MixedRealityLab/UbiDesign/protocol/component_images/shower hose.jpg

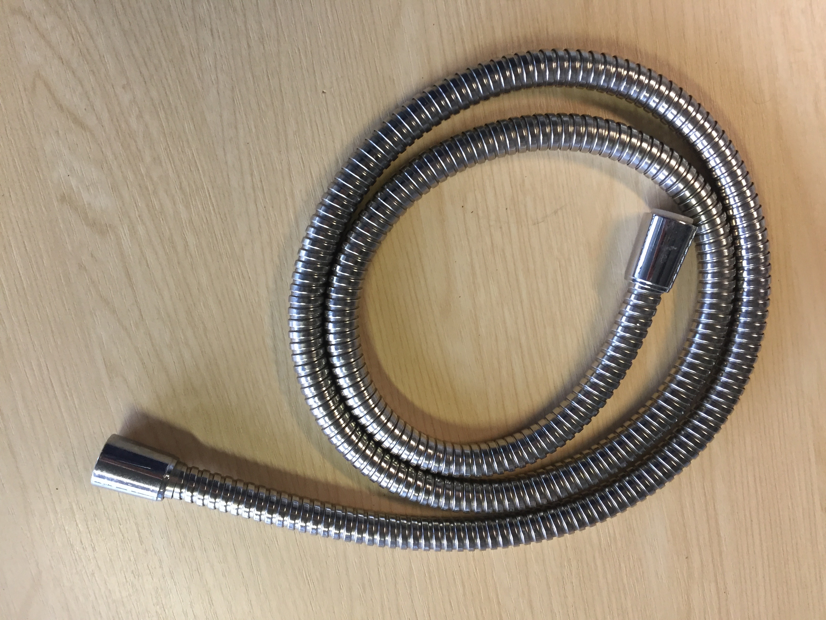
protocol/component_images/shower hose.jpg
