MixedRealityLab/UbiDesign/protocol/component_images/jst pcb header.jpg

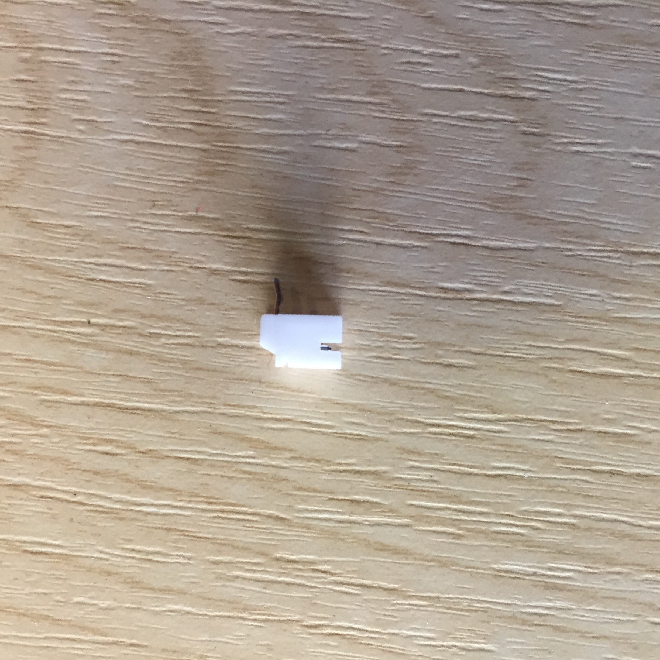
protocol/component_images/jst pcb header.jpg
