MixedRealityLab/UbiDesign/protocol/component_images/electronics for shower monitor.jpg

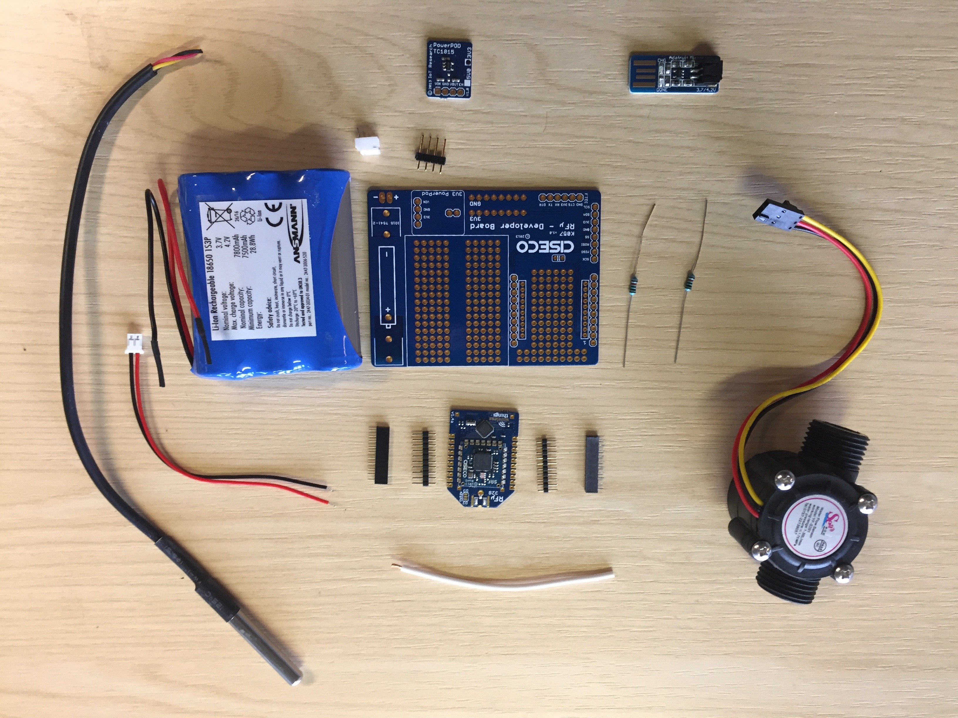
protocol/component_images/electronics for shower monitor.jpg
