MixedRealityLab/UbiDesign/protocol/component_images/2mm header pins.jpg

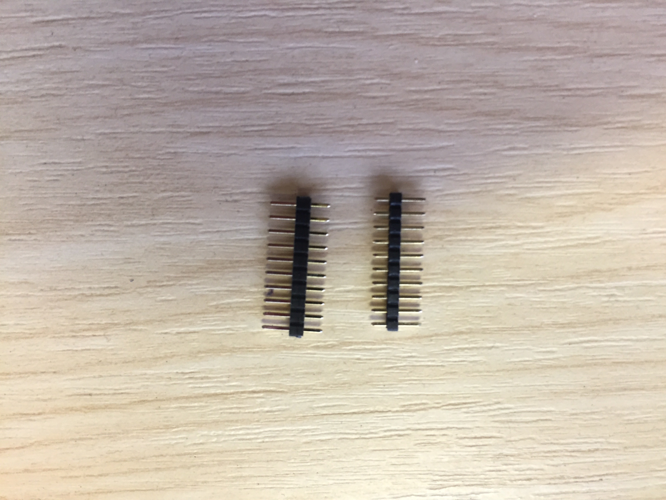
protocol/component_images/2mm header pins.jpg
