MixedRealityLab/UbiDesign/protocol/component_images/2mm sockets.jpg

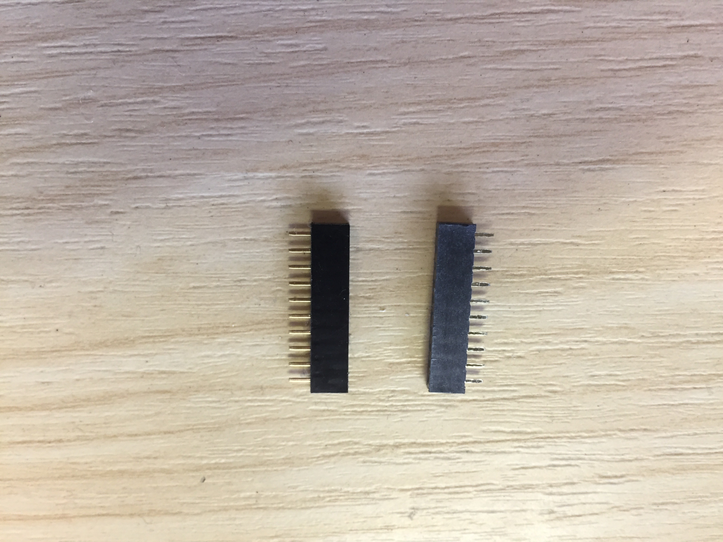
protocol/component_images/2mm sockets.jpg
