MixedRealityLab/UbiDesign/protocol/component_images/4 core white sheathed wire.jpg

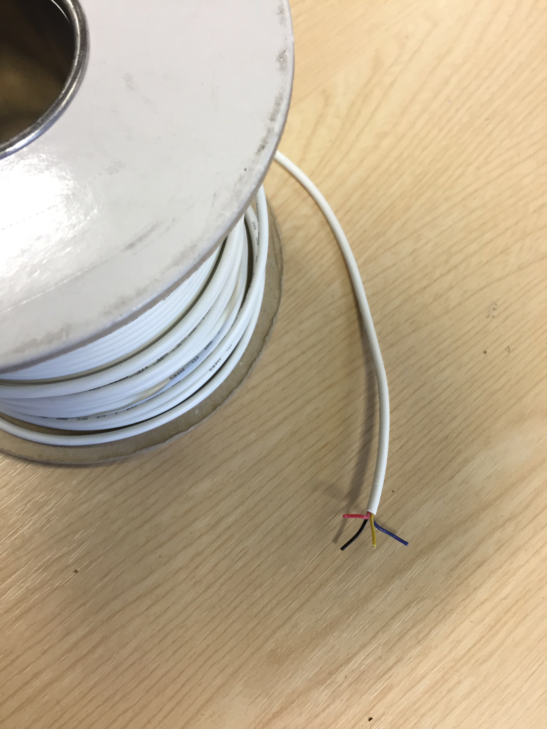
protocol/component_images/4 core white sheathed wire.jpg
