MixedRealityLab/UbiDesign/protocol/component_images/10k resistors.jpg

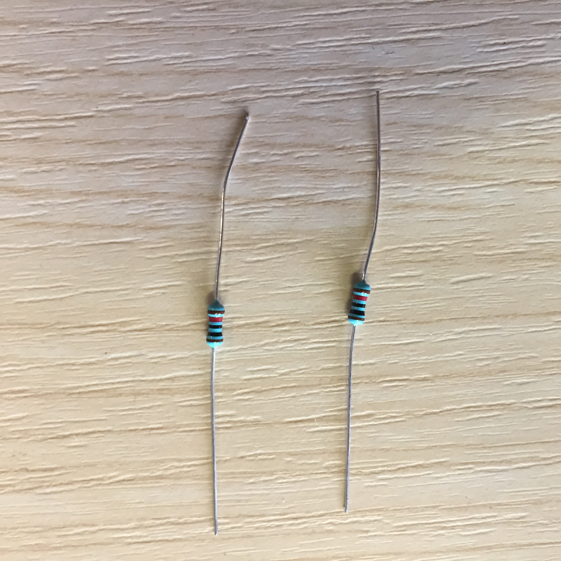
protocol/component_images/10k resistors.jpg
