MixedRealityLab/UbiDesign/protocol/component_images/15mm push fit to BSP hose.jpg

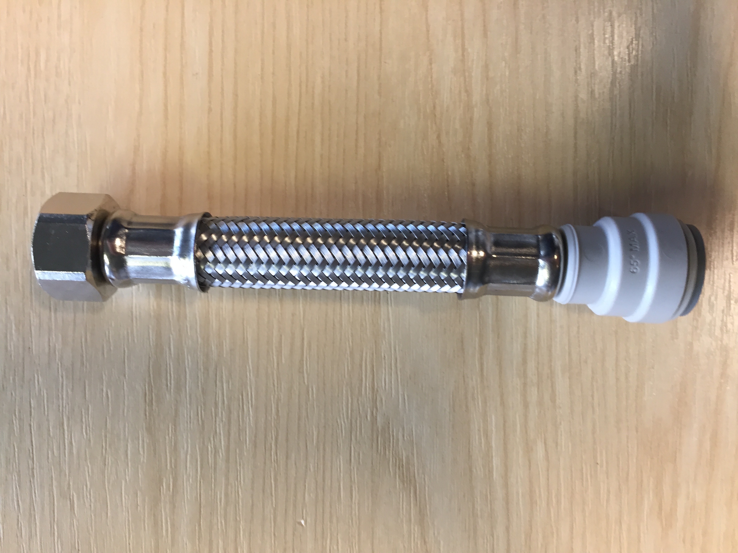
protocol/component_images/15mm push fit to BSP hose.jpg
