MixedRealityLab/UbiDesign/protocol/component_images/15mm push fit to bsp plastic.jpg

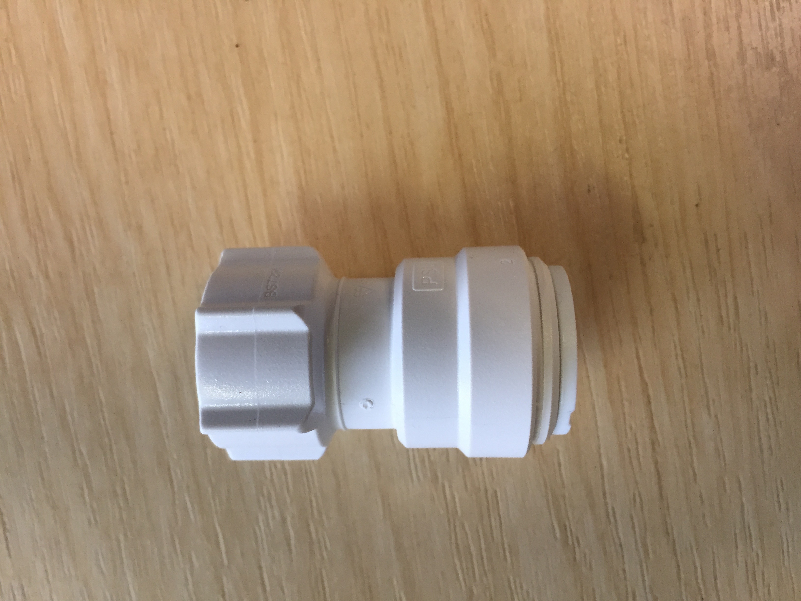
protocol/component_images/15mm push fit to bsp plastic.jpg
