MixedRealityLab/UbiDesign/protocol/component_images/22awg single core wire.jpg

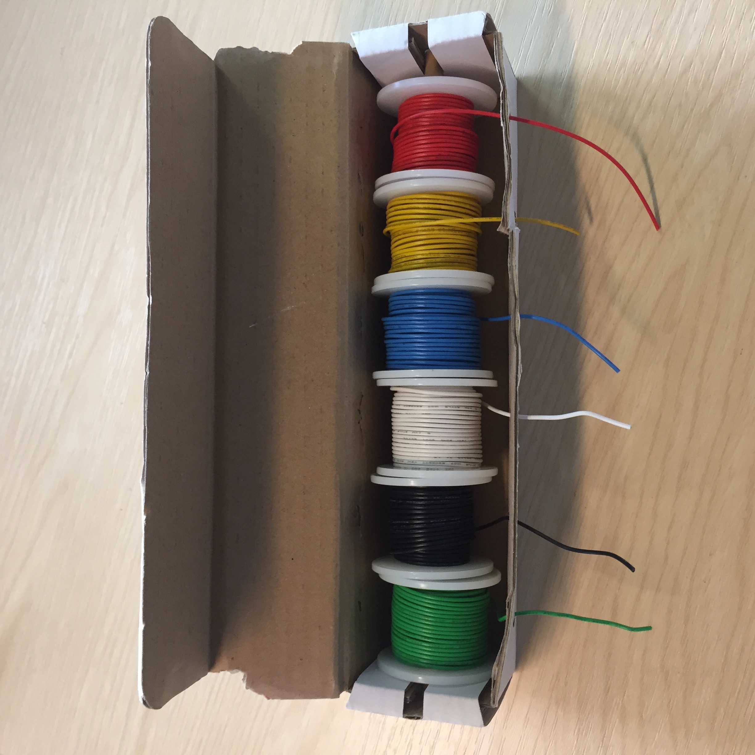
protocol/component_images/22awg single core wire.jpg
