MixedRealityLab/UbiDesign/protocol/component_images/500g load cell 1.jpg

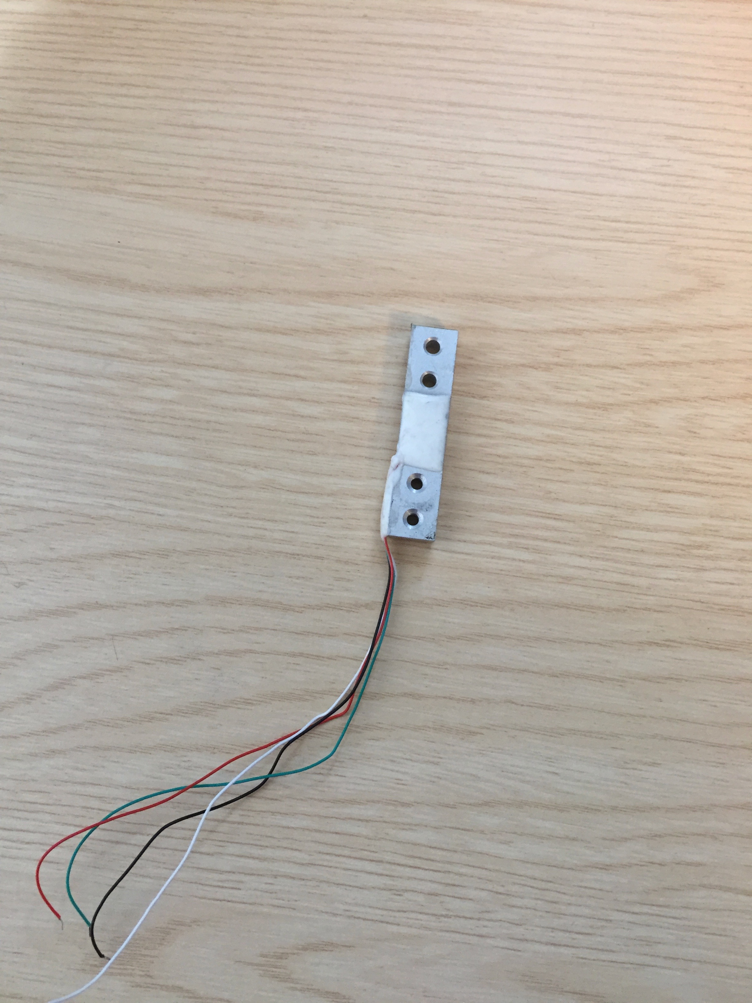
protocol/component_images/500g load cell 1.jpg
