MixedRealityLab/UbiDesign/protocol/component_images/500g load cell 2.jpg

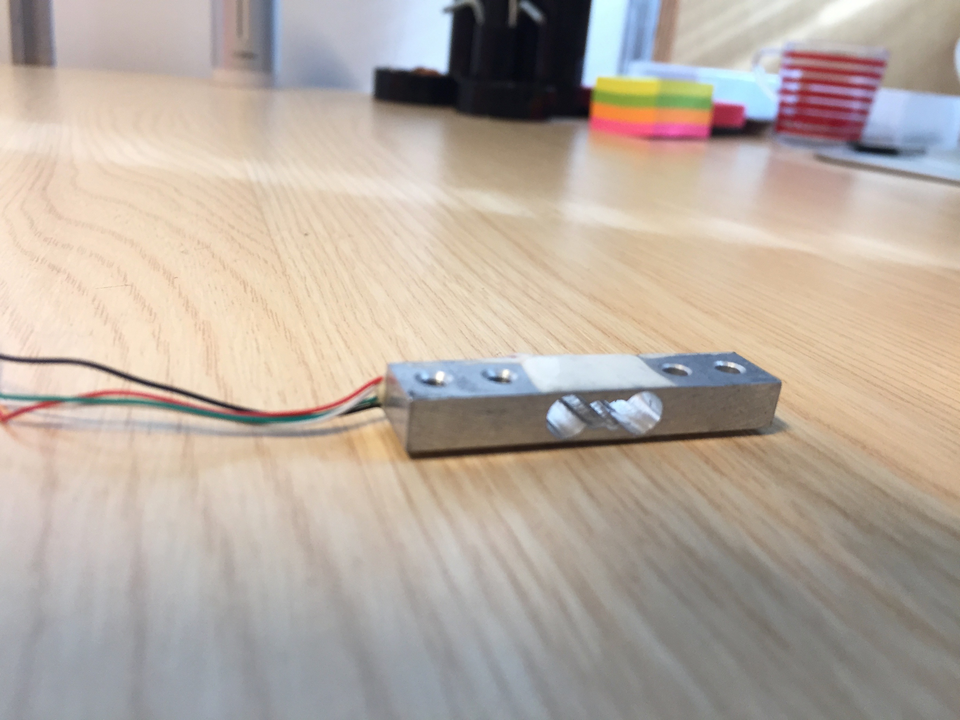
protocol/component_images/500g load cell 2.jpg
