MixedRealityLab/UbiDesign/protocol/component_images/500g load cell 3.jpg

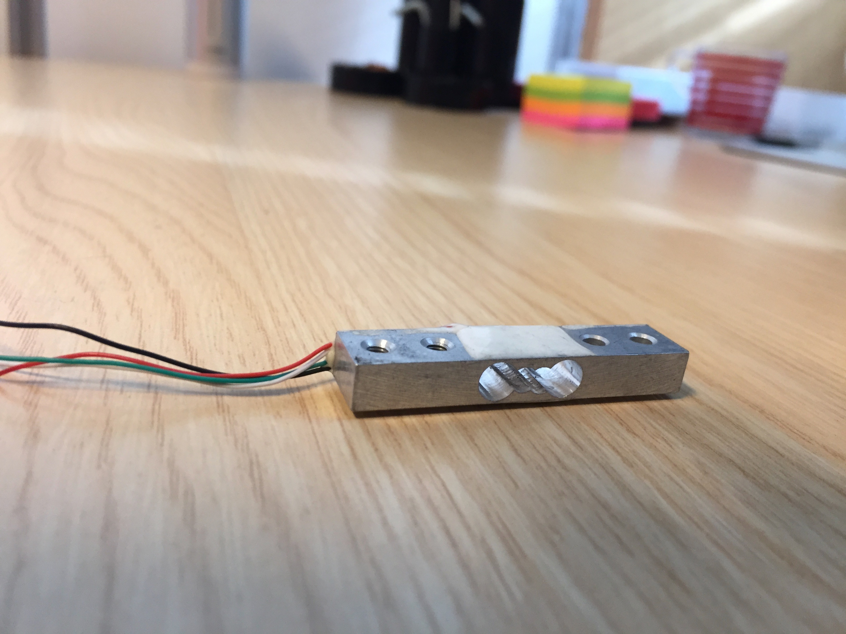
protocol/component_images/500g load cell 3.jpg
