MixedRealityLab/UbiDesign/protocol/component_images/7800mah 18650 battery.jpg

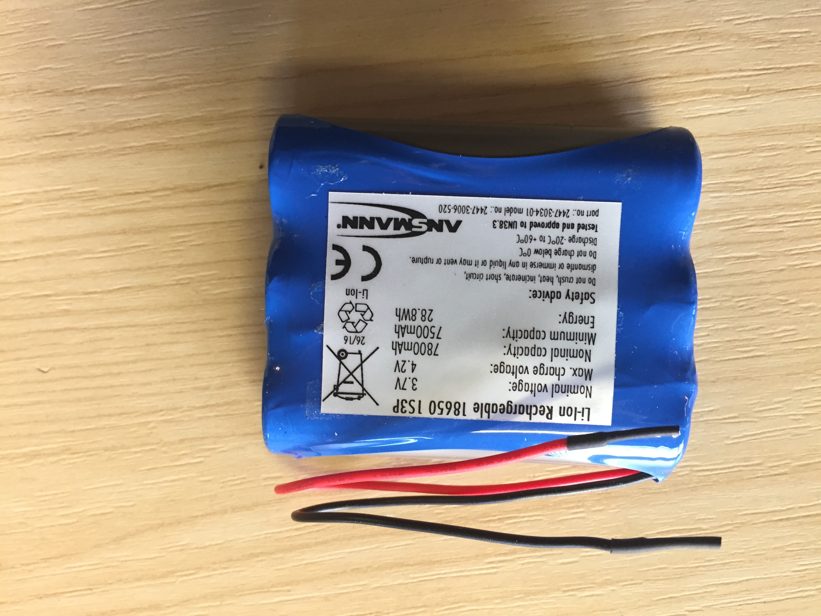
protocol/component_images/7800mah 18650 battery.jpg
