MixedRealityLab/UbiDesign/protocol/component_images/antenna wire.jpg

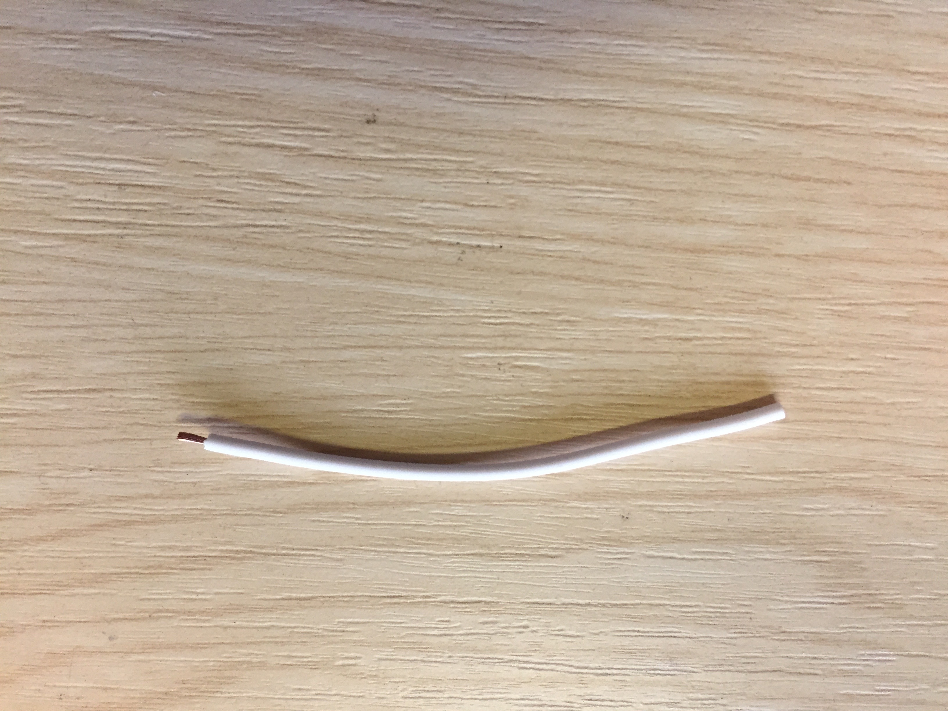
protocol/component_images/antenna wire.jpg
