MixedRealityLab/UbiDesign/protocol/component_images/ble feather.jpg

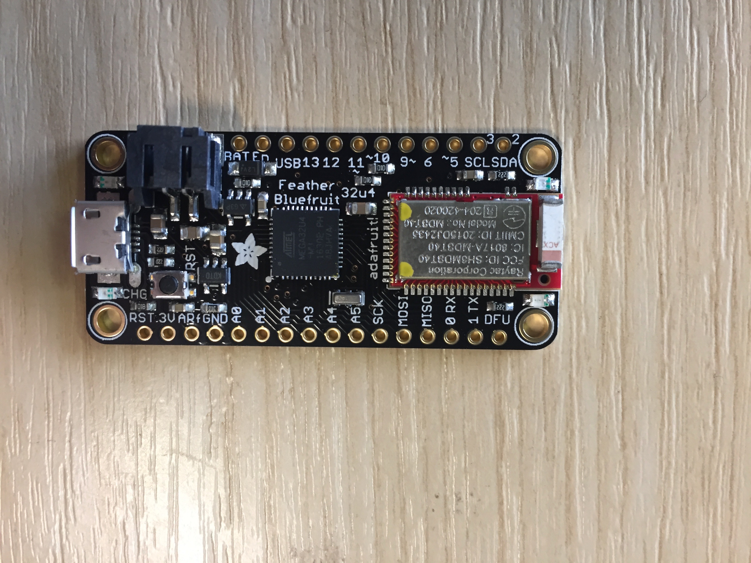
protocol/component_images/ble feather.jpg
