MixedRealityLab/UbiDesign/protocol/component_images/ble uart friend 2.jpg

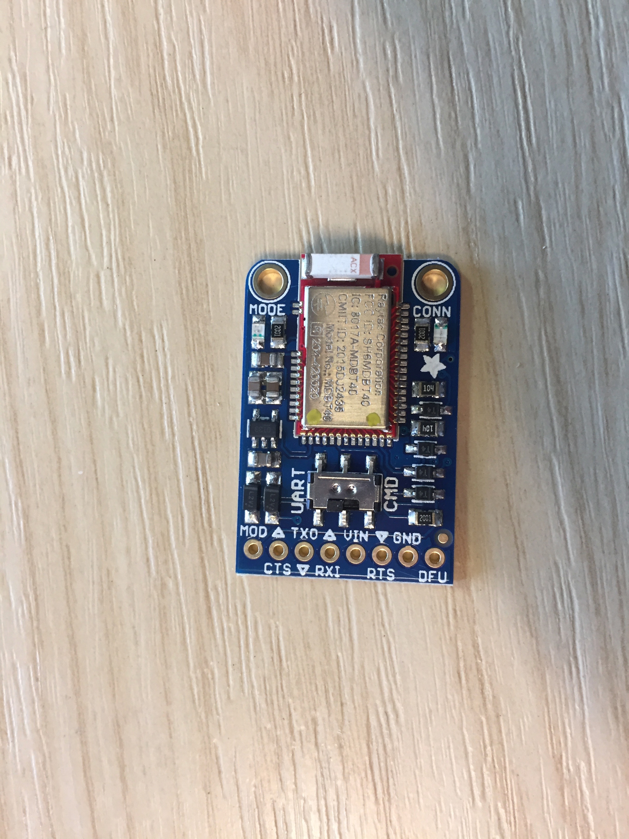
protocol/component_images/ble uart friend 2.jpg
