MixedRealityLab/UbiDesign/protocol/component_images/ble uart friend.jpg

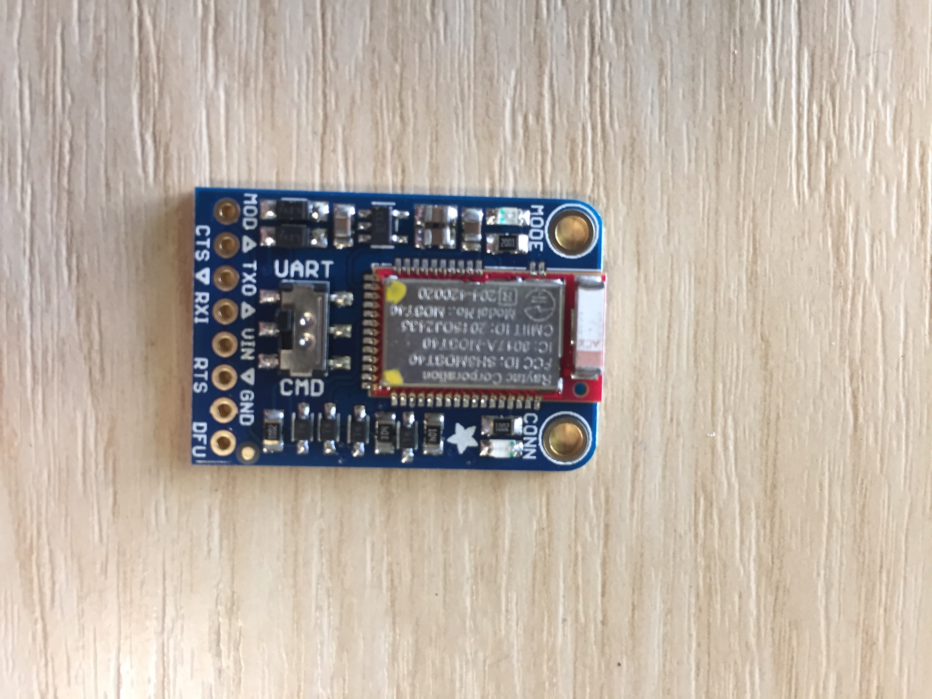
protocol/component_images/ble uart friend.jpg
