MixedRealityLab/UbiDesign/protocol/component_images/BNO055 9 axis motion sensor.jpg

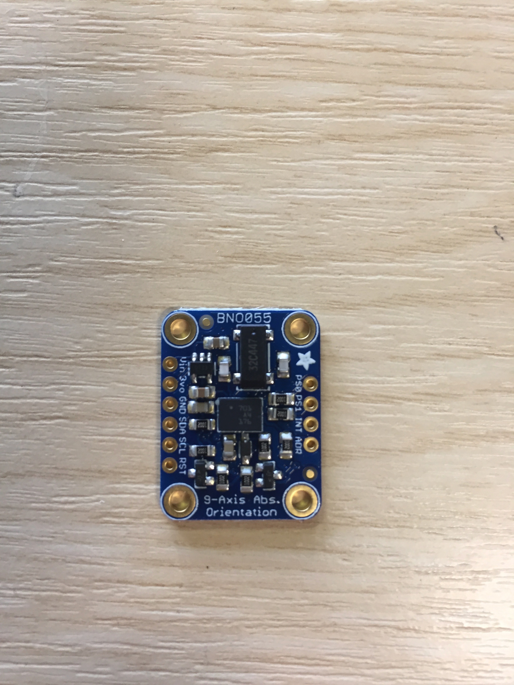
protocol/component_images/BNO055 9 axis motion sensor.jpg
