MixedRealityLab/UbiDesign/protocol/component_images/copper pipe.jpg

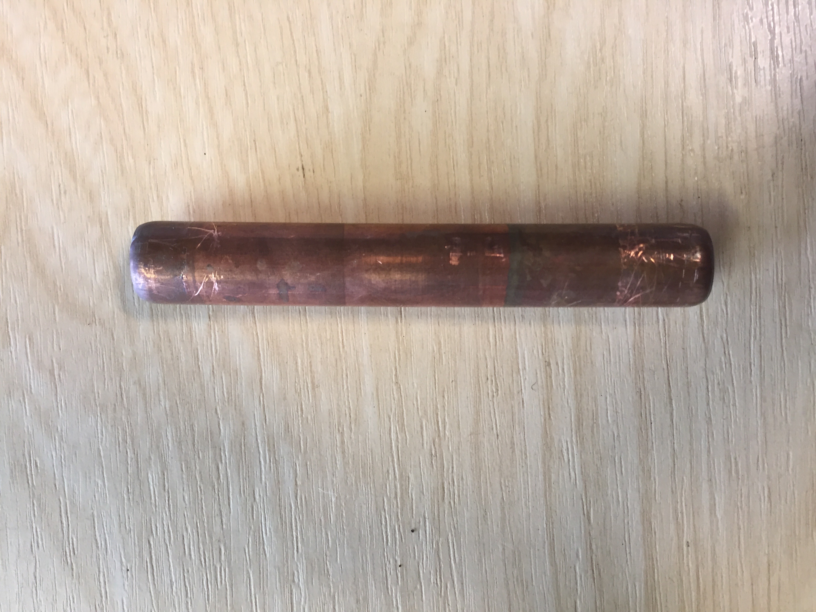
protocol/component_images/copper pipe.jpg
