MixedRealityLab/UbiDesign/protocol/component_images/flow sensor.jpg

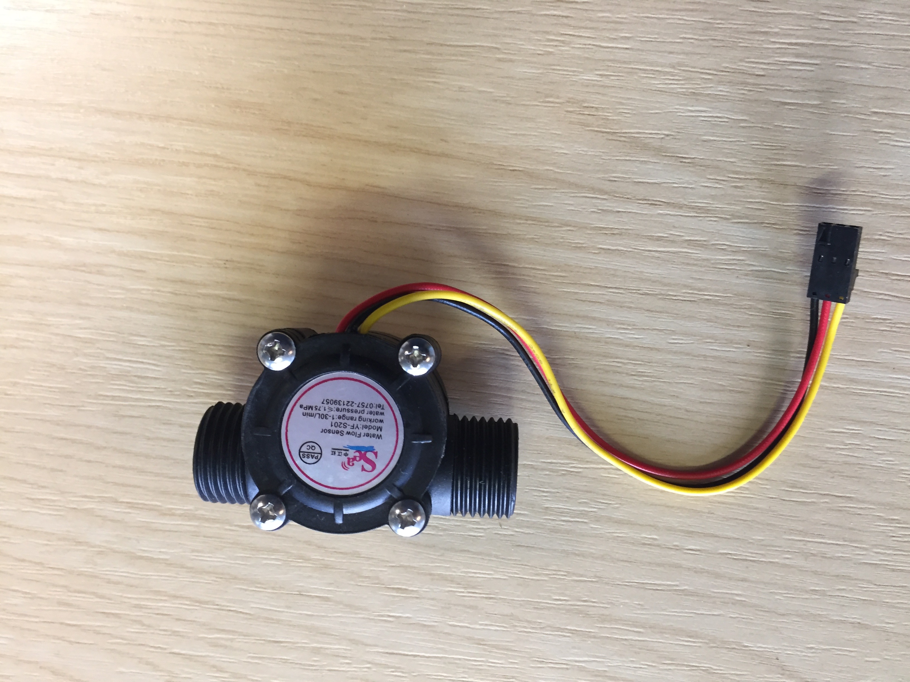
protocol/component_images/flow sensor.jpg
