MixedRealityLab/UbiDesign/protocol/component_images/jst 2 wire assebmly.jpg

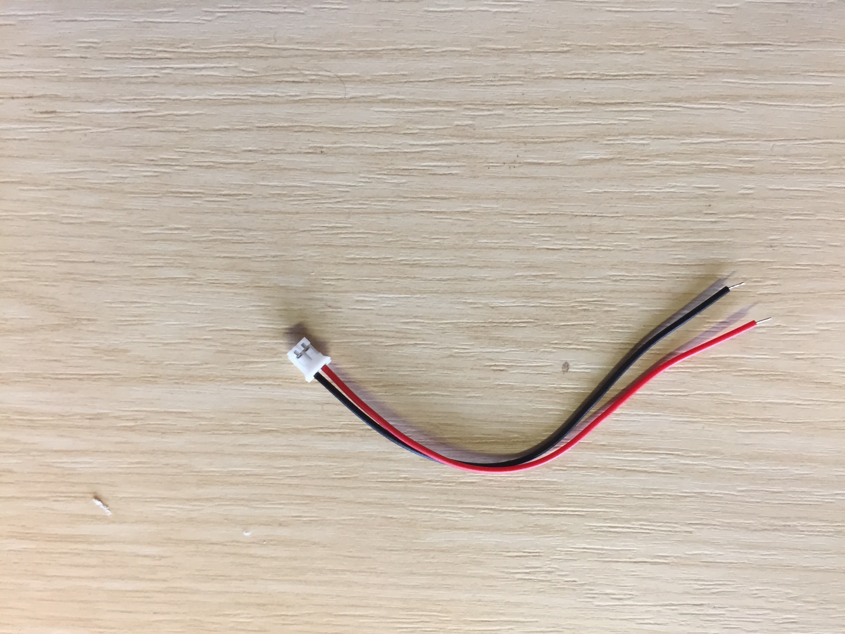
protocol/component_images/jst 2 wire assebmly.jpg
