MixedRealityLab/UbiDesign/protocol/component_images/lipo battery charger.jpg

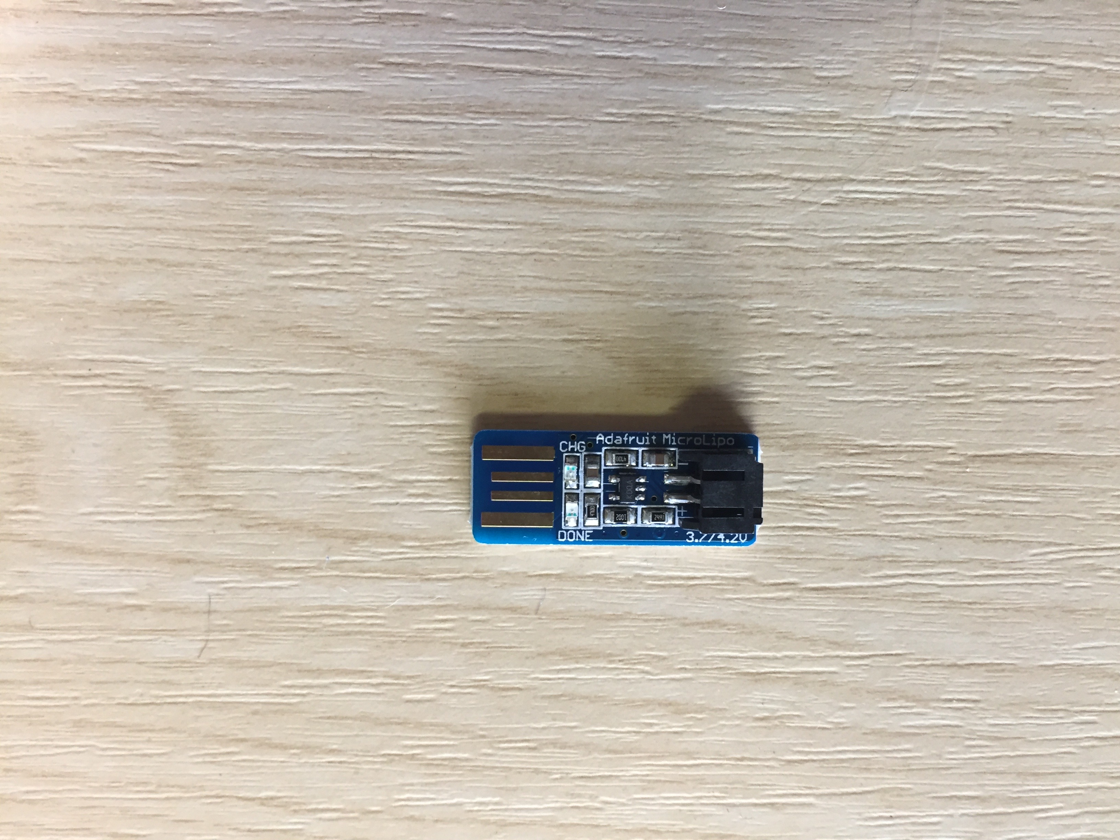
protocol/component_images/lipo battery charger.jpg
