MixedRealityLab/UbiDesign/protocol/component_images/open scale board.jpg

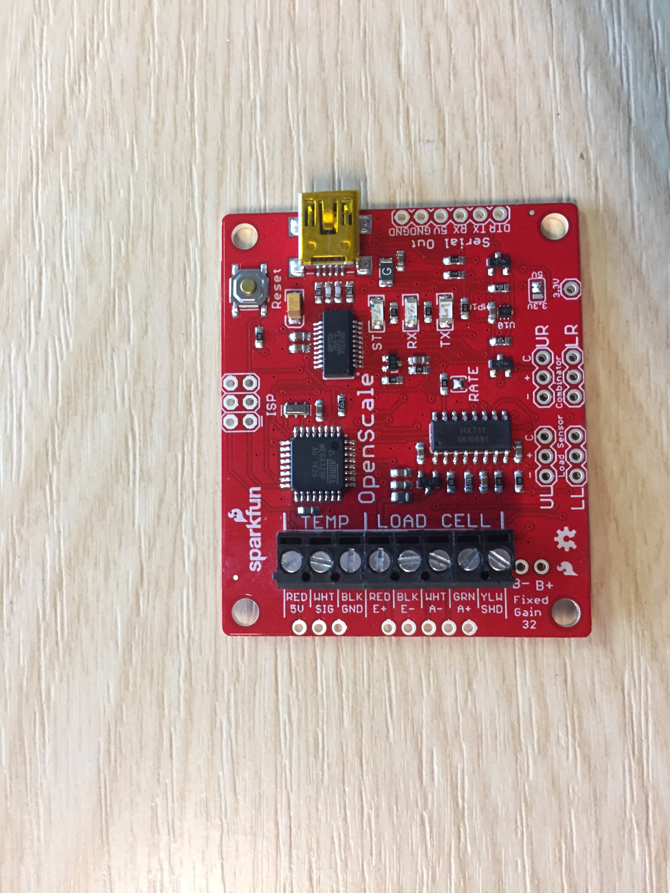
protocol/component_images/open scale board.jpg
