MixedRealityLab/UbiDesign/protocol/component_images/pipe cutter.jpg

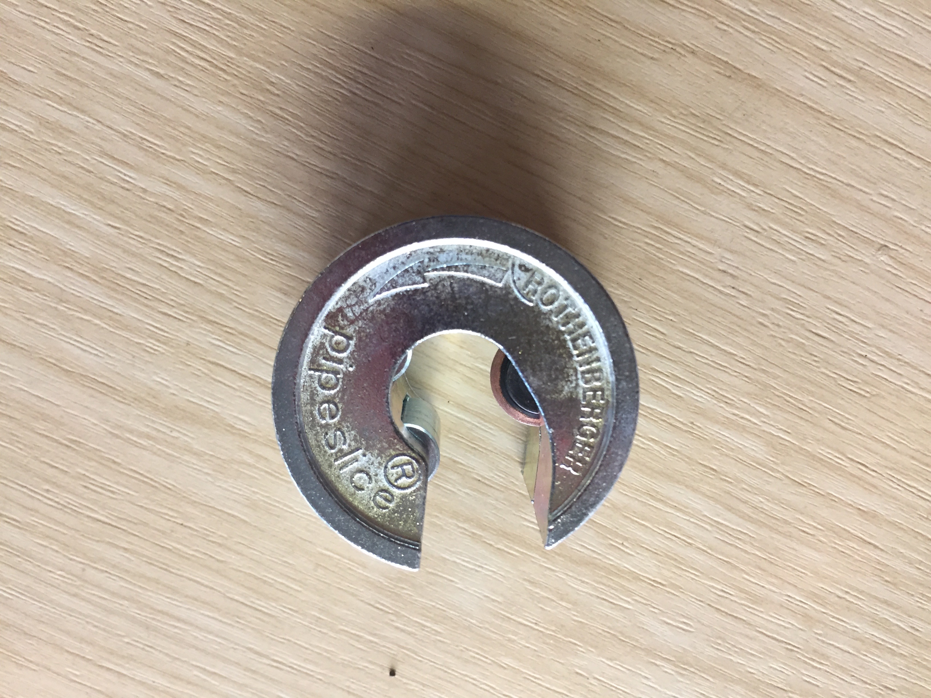
protocol/component_images/pipe cutter.jpg
