MixedRealityLab/UbiDesign/protocol/component_images/rfµ328 board.jpg

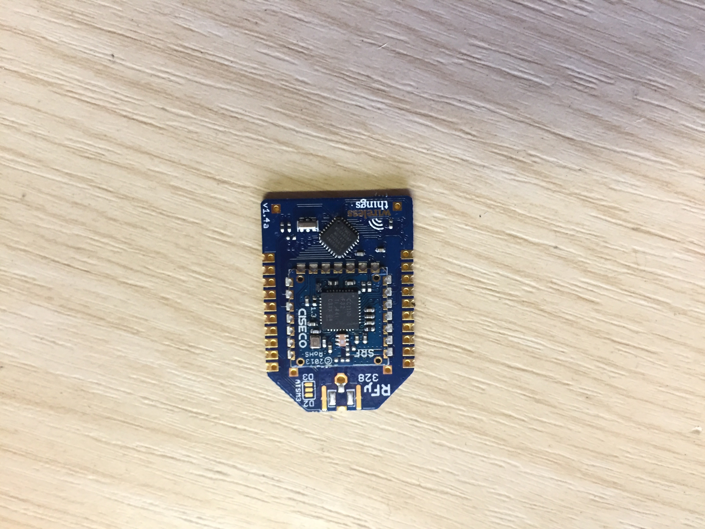
protocol/component_images/rfµ328 board.jpg
