MixedRealityLab/UbiDesign/protocol/component_images/rfµ dev boar.jpg

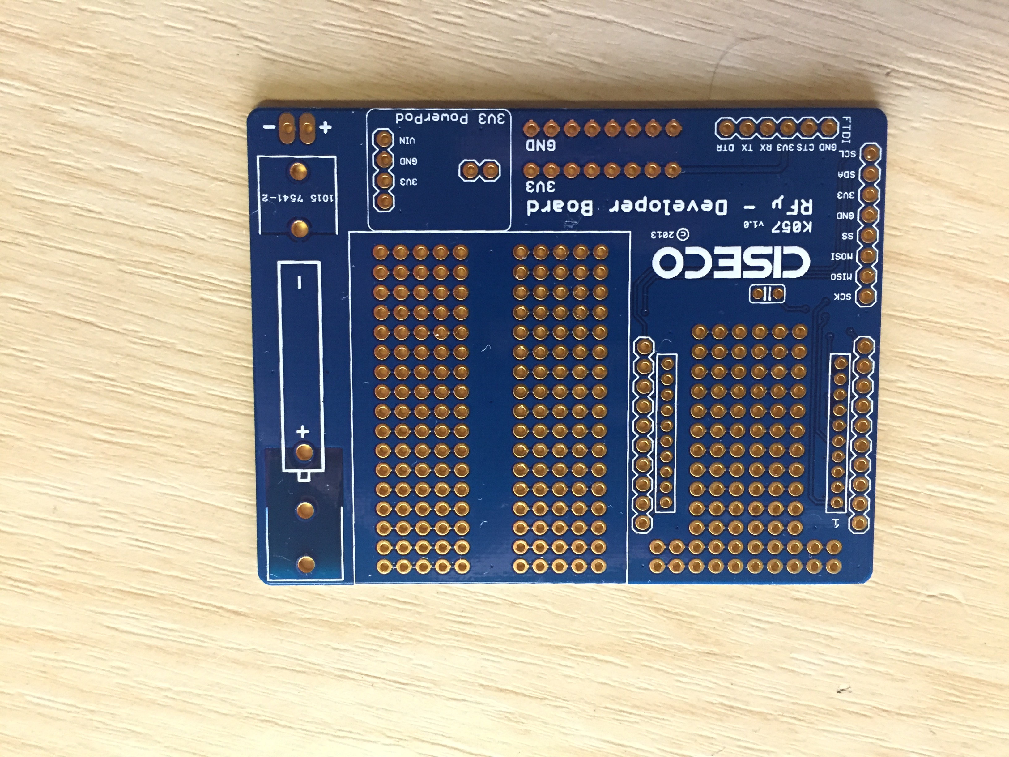
protocol/component_images/rfµ dev boar.jpg
