MixedRealityLab/UbiDesign/protocol/component_images/shower monitor enclosure.jpg

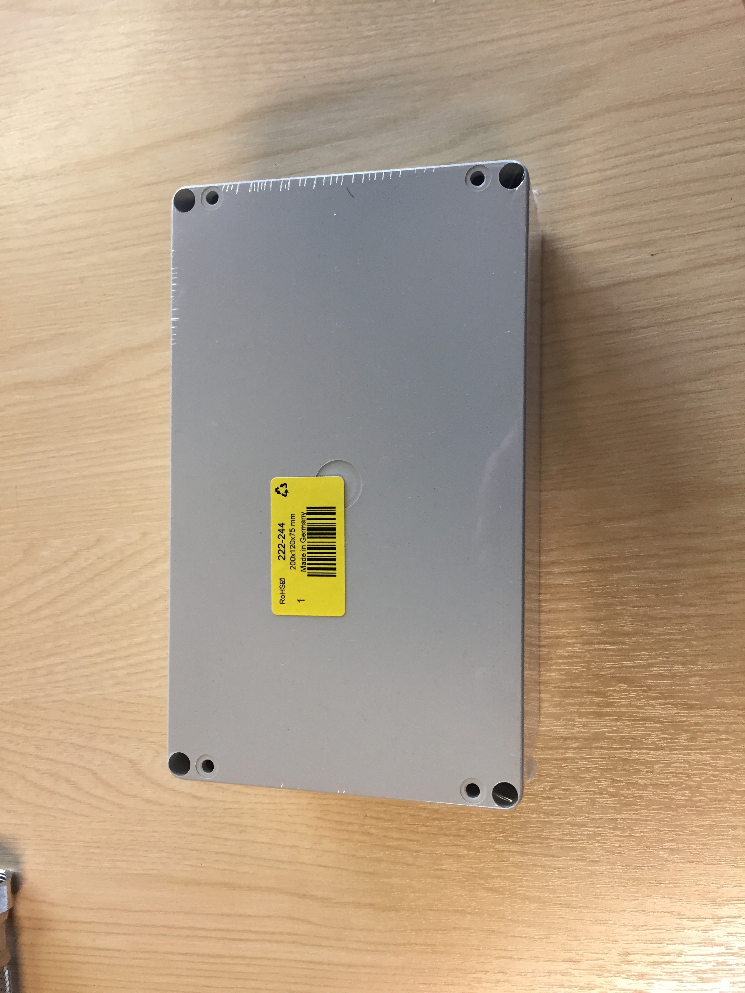
protocol/component_images/shower monitor enclosure.jpg
