MixedRealityLab/UbiDesign/protocol/component_images/srf stick 1.jpg

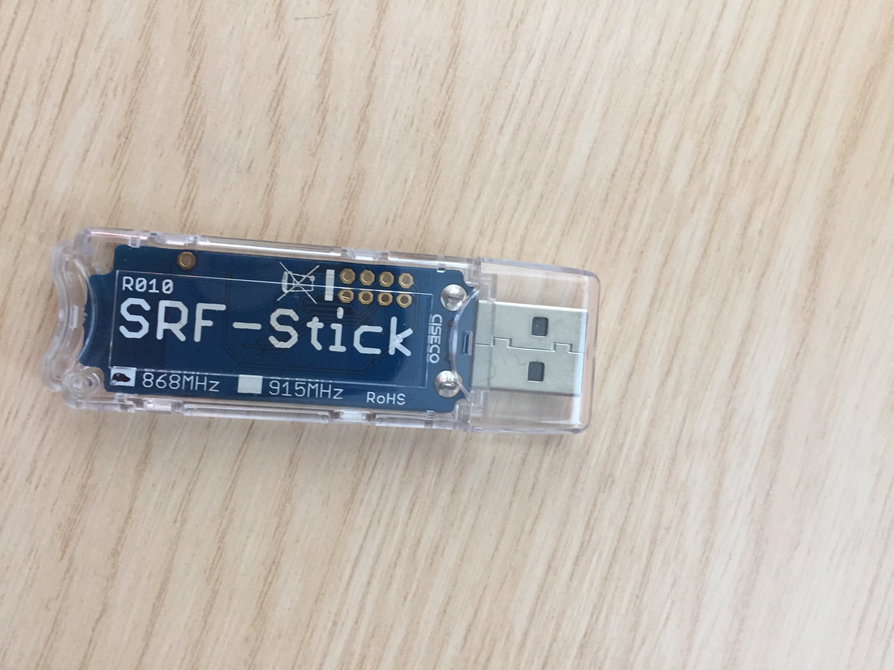
protocol/component_images/srf stick 1.jpg
