MixedRealityLab/UbiDesign/protocol/component_images/srf stick 2.jpg

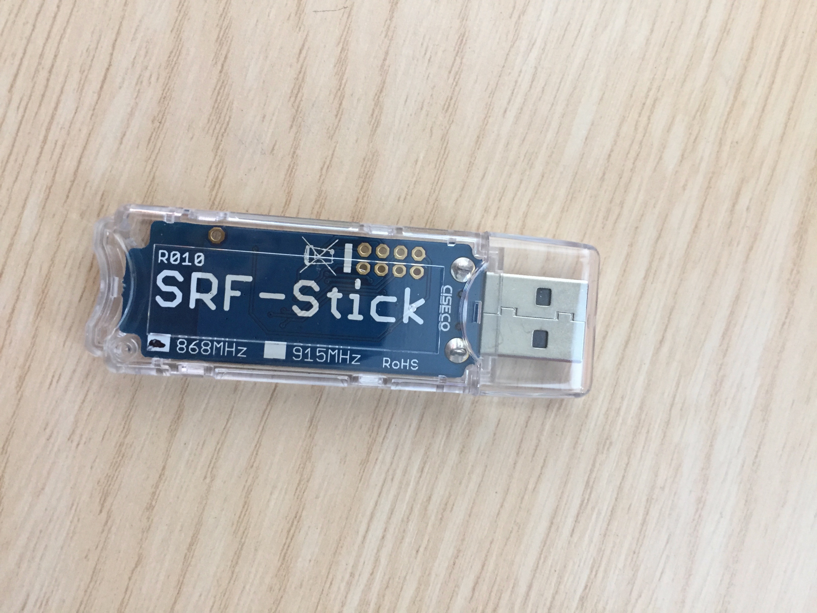
protocol/component_images/srf stick 2.jpg
