MixedRealityLab/UbiDesign/protocol/component_images/TC1015 voltage regulator.jpg

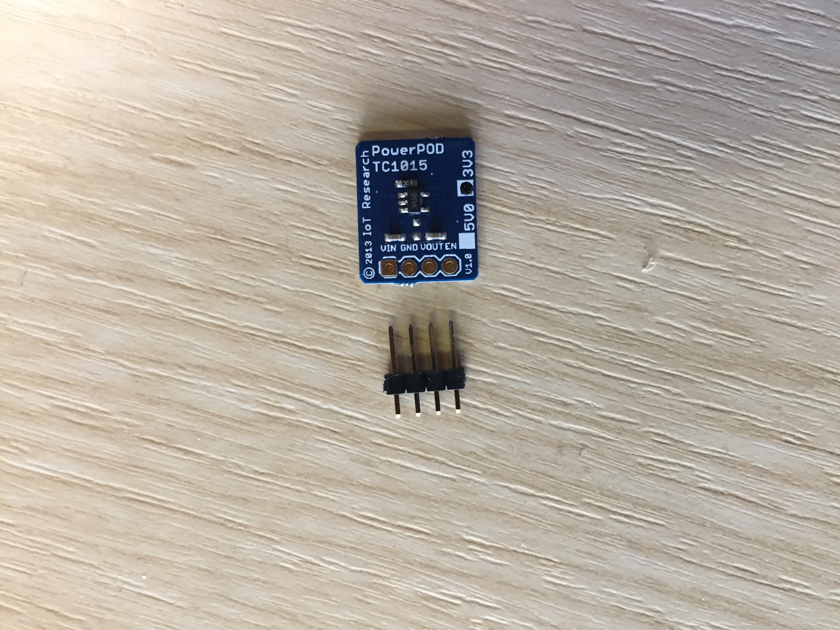
protocol/component_images/TC1015 voltage regulator.jpg
