MixedRealityLab/UbiDesign/protocol/component_images/temperature sensor.jpg

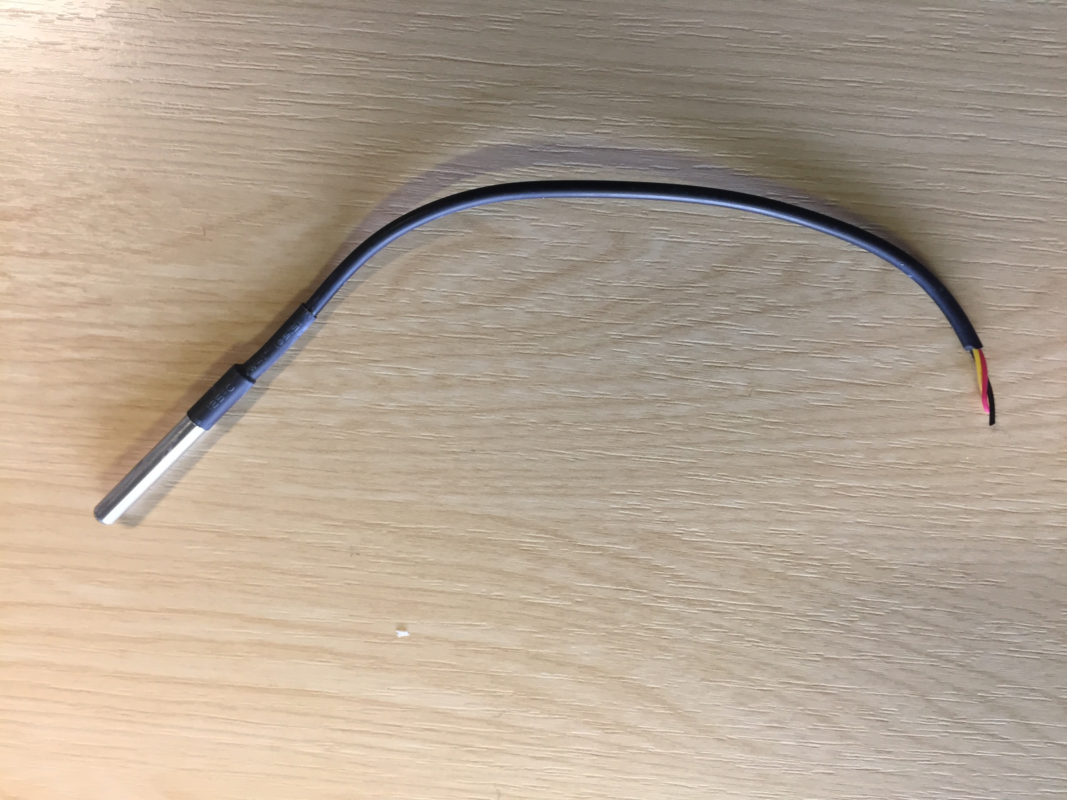
protocol/component_images/temperature sensor.jpg
