MixedRealityLab/UbiDesign/protocol/component_images/wireless things voyager.jpg

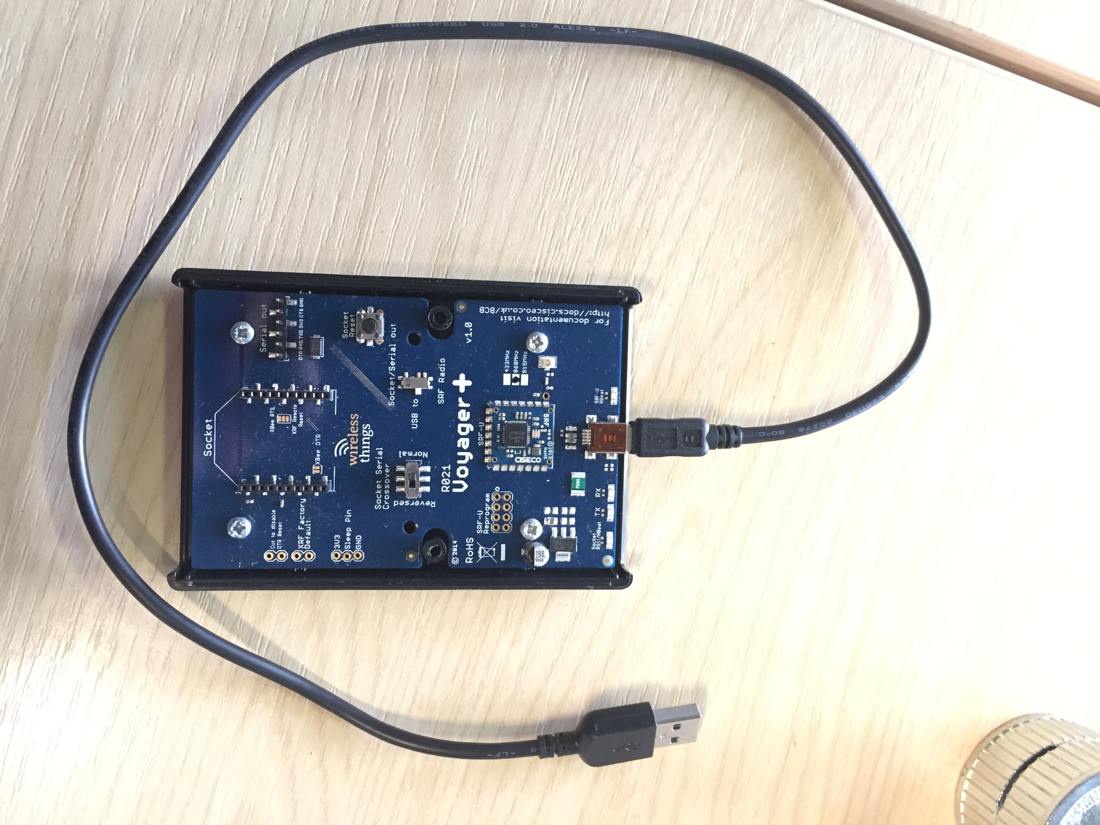
protocol/component_images/wireless things voyager.jpg
