MixedRealityLab/UbiDesign/protocol/component_images/scale assembly 1.jpg

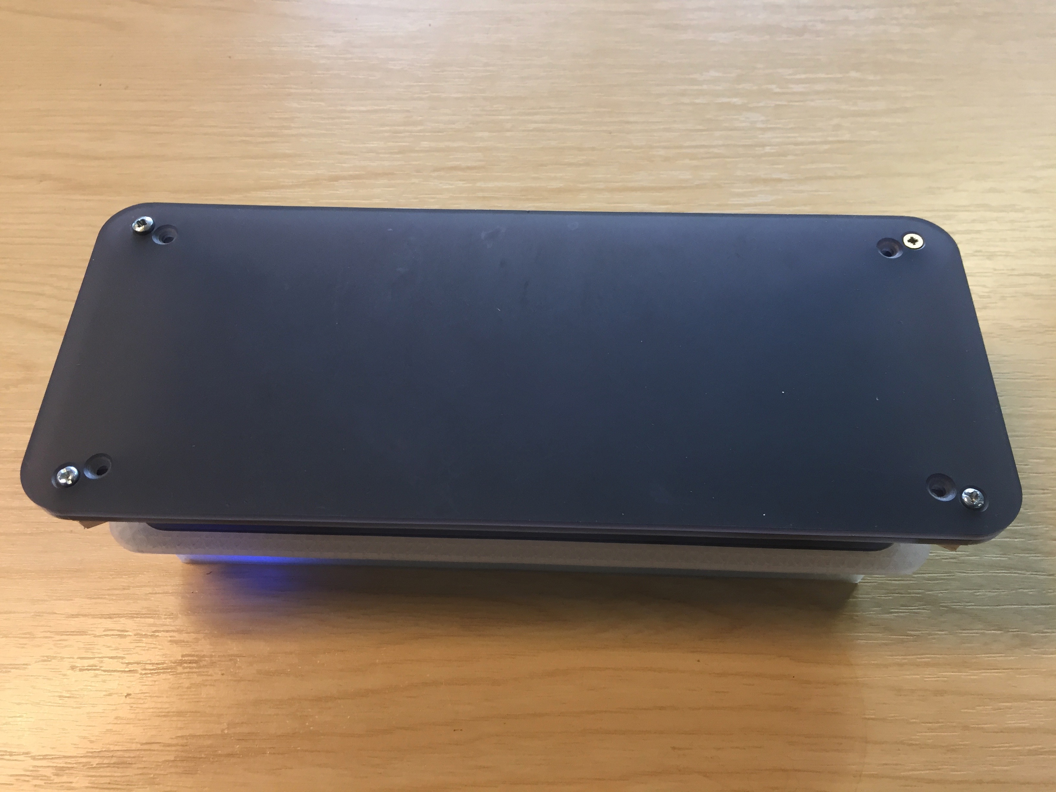
protocol/component_images/scale assembly 1.jpg
