MixedRealityLab/UbiDesign/protocol/component_images/scale assembly 3.jpg

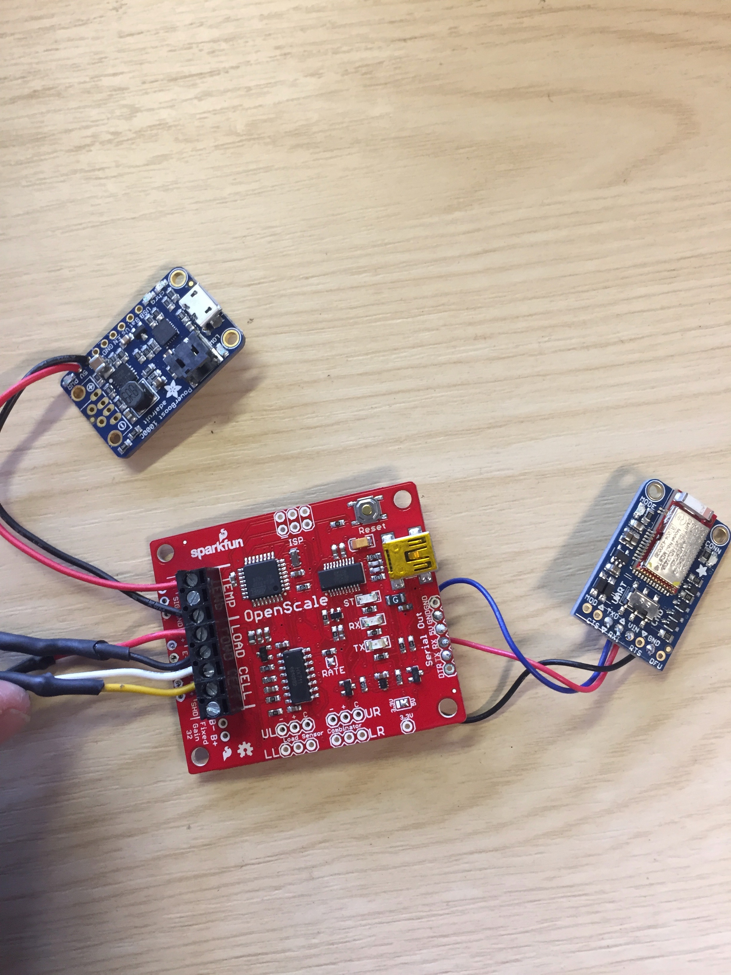
protocol/component_images/scale assembly 3.jpg
