MixedRealityLab/UbiDesign/protocol/component_images/scale assembly 4.jpg

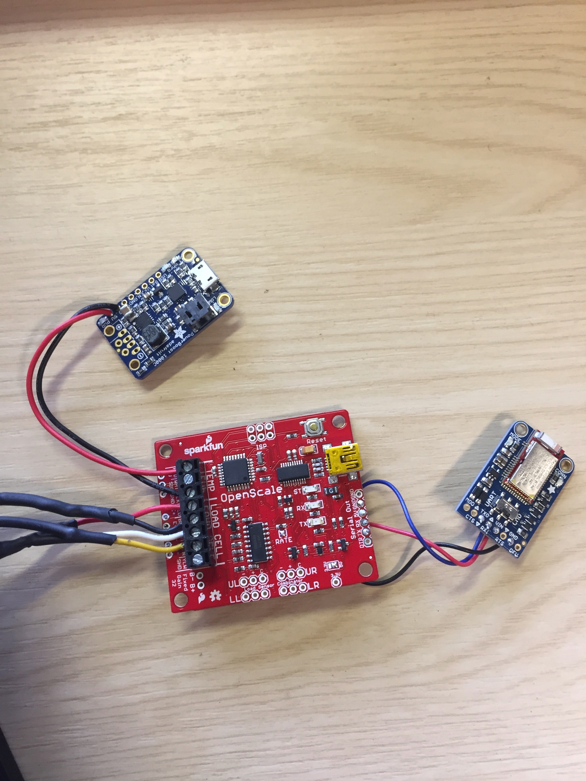
protocol/component_images/scale assembly 4.jpg
