MixedRealityLab/UbiDesign/protocol/component_images/scale assembly 6.jpg

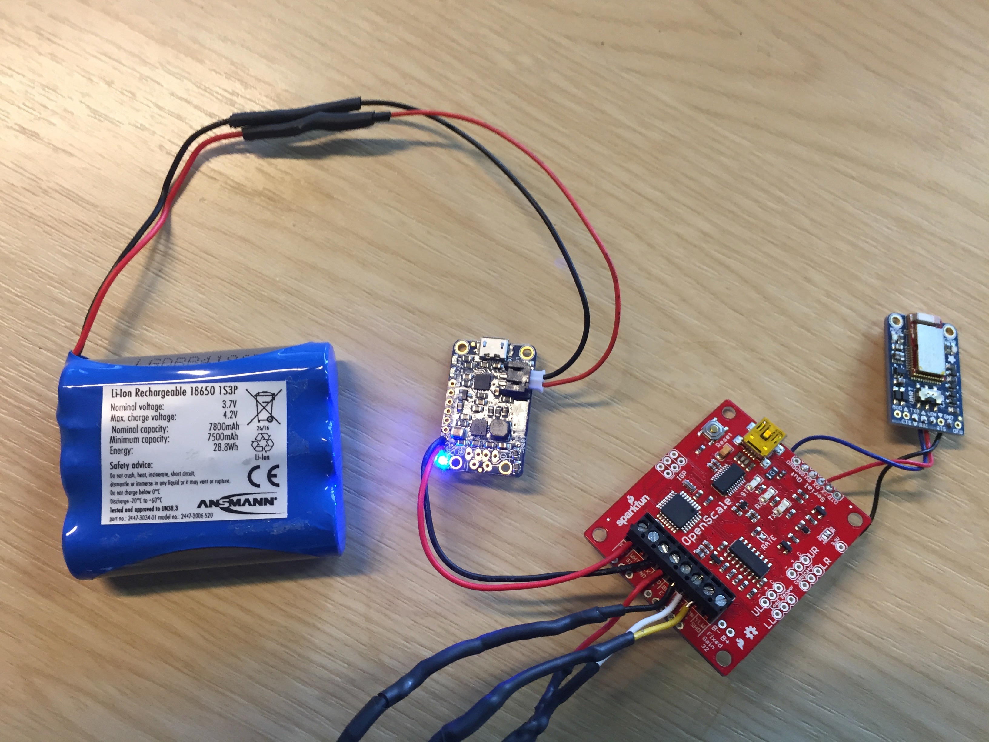
protocol/component_images/scale assembly 6.jpg
