MixedRealityLab/UbiDesign/protocol/component_images/scale assembly 7.jpg

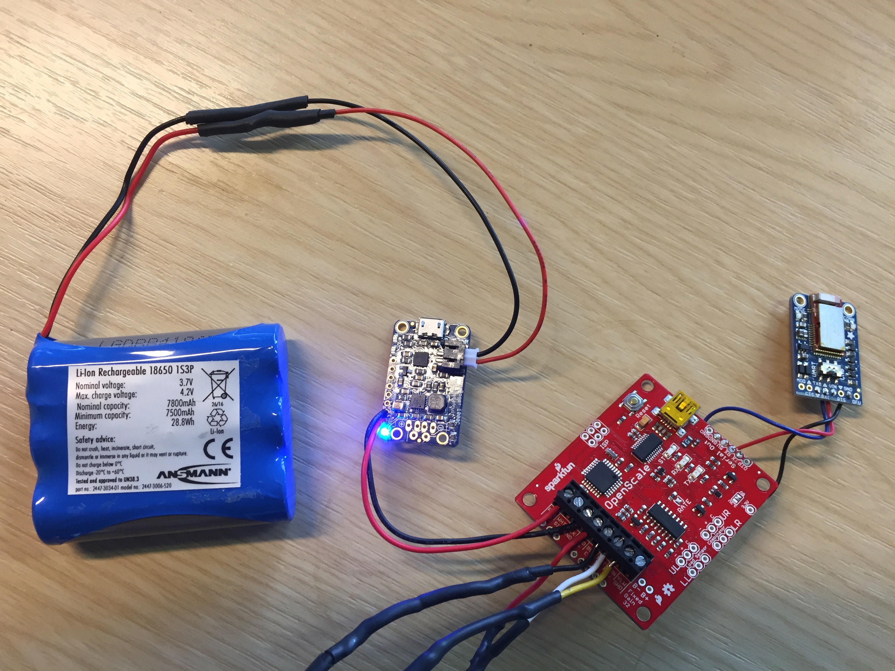
protocol/component_images/scale assembly 7.jpg
