MixedRealityLab/UbiDesign/protocol/component_images/scale assembly 8.jpg

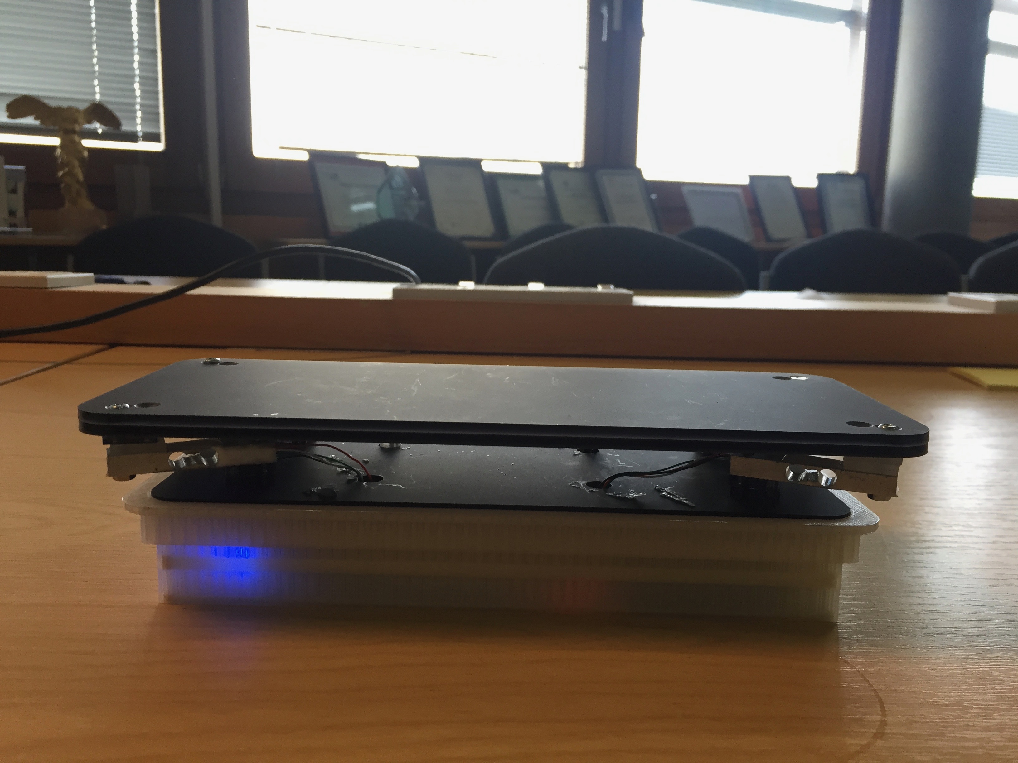
protocol/component_images/scale assembly 8.jpg
