MixedRealityLab/UbiDesign/protocol/component_images/scale assembly 9.jpg

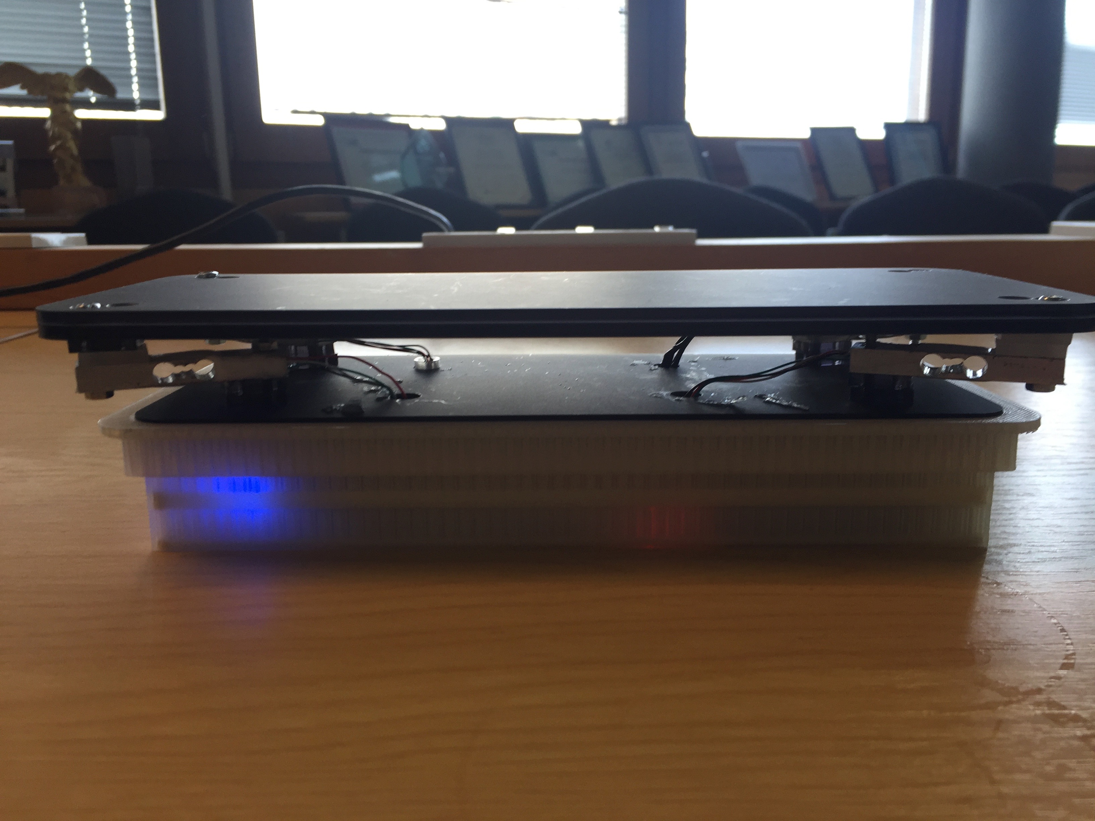
protocol/component_images/scale assembly 9.jpg
