MixedRealityLab/UbiDesign/protocol/component_images/scale assembly 10.jpg

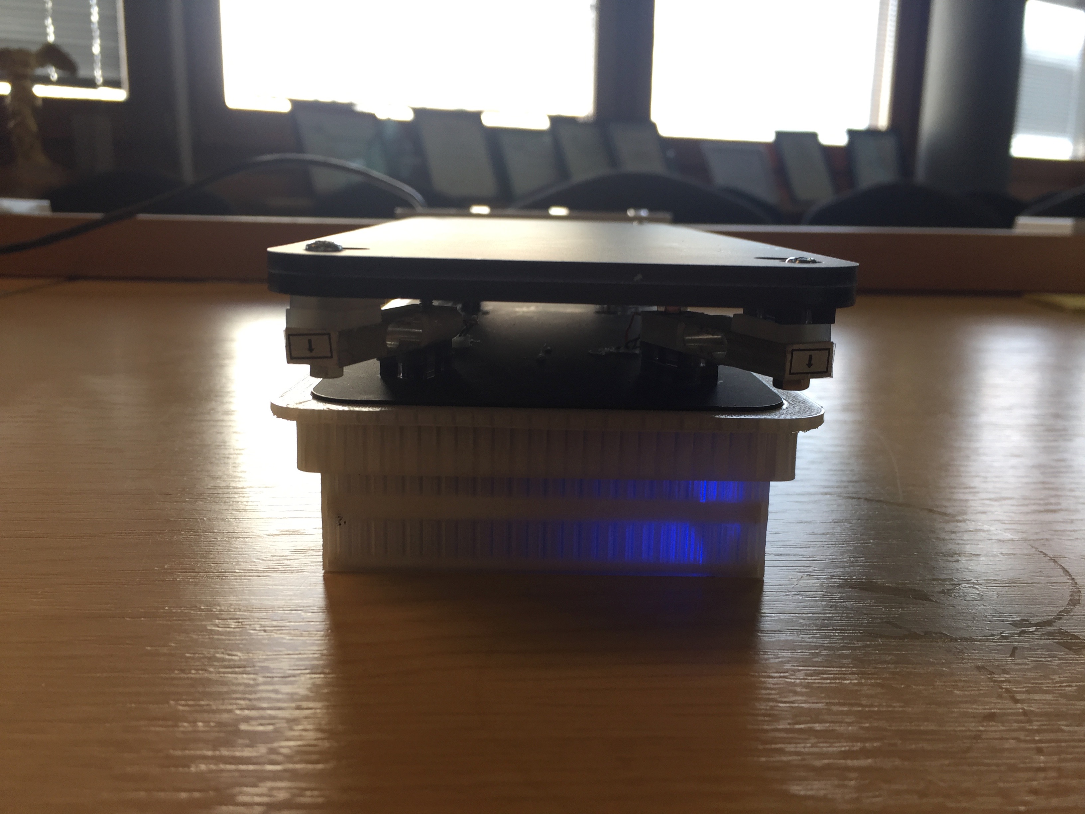
protocol/component_images/scale assembly 10.jpg
