MixedRealityLab/UbiDesign/protocol/component_images/scale assembly 12.jpg

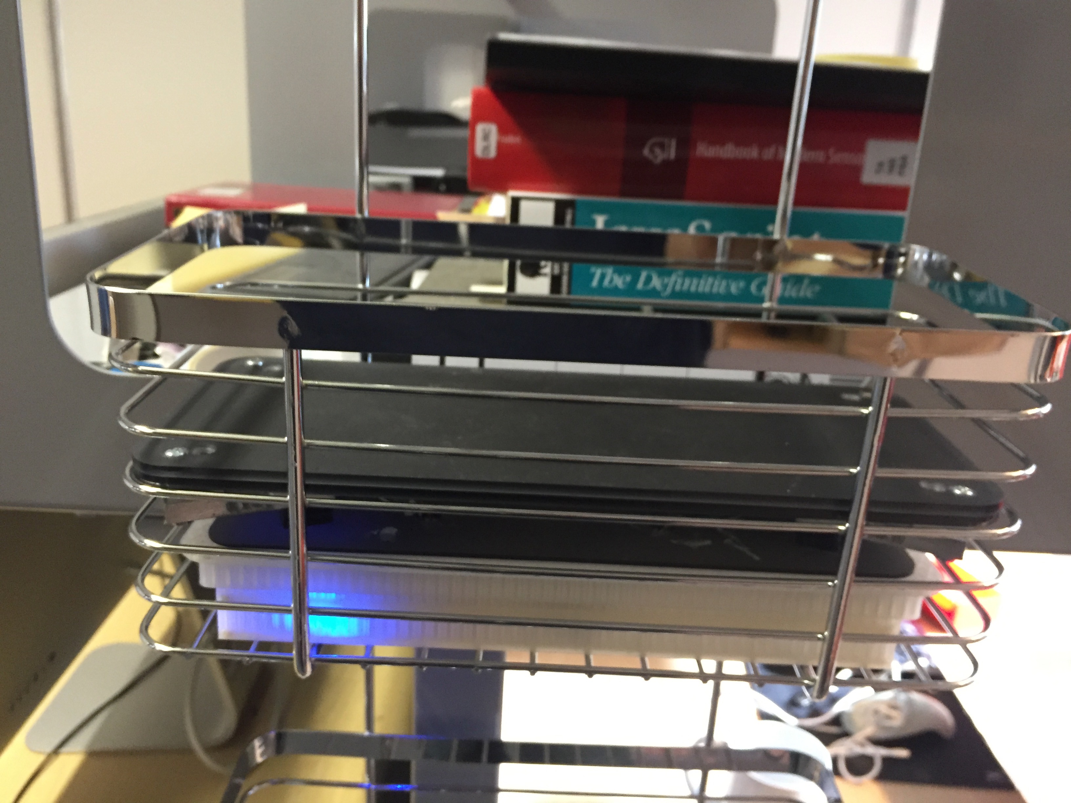
protocol/component_images/scale assembly 12.jpg
