MixedRealityLab/UbiDesign/protocol/component_images/scale assembly 13.jpg

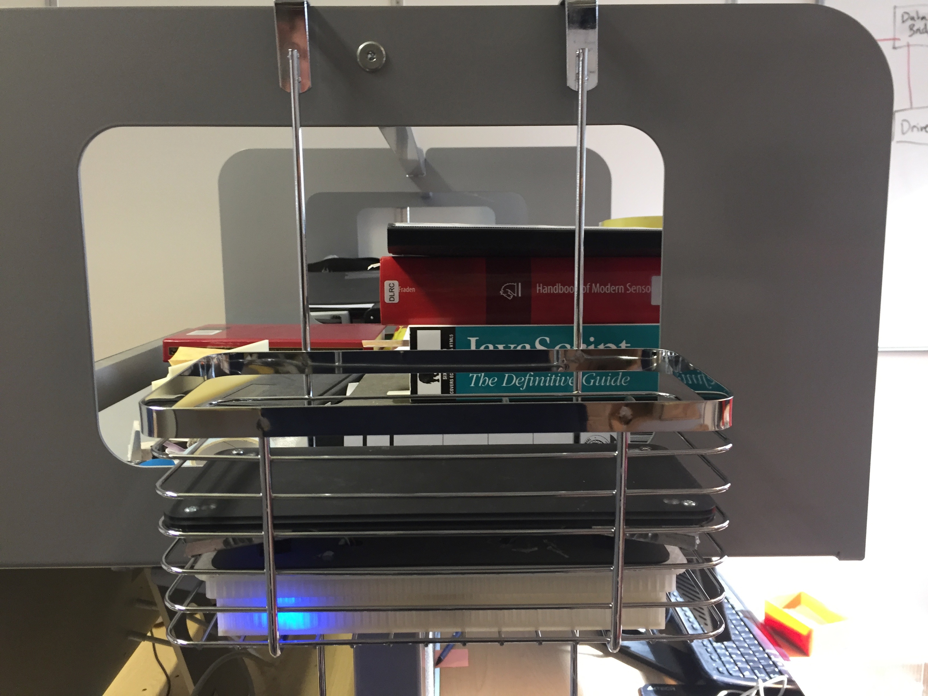
protocol/component_images/scale assembly 13.jpg
