MixedRealityLab/UbiDesign/protocol/component_images/scale assembly 14.jpg

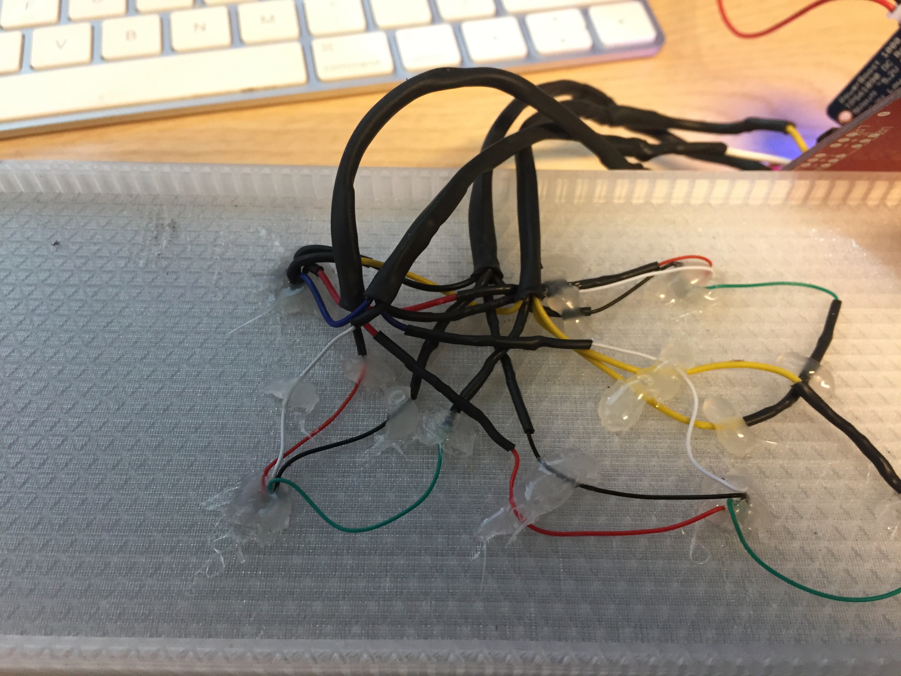
protocol/component_images/scale assembly 14.jpg
