MixedRealityLab/UbiDesign/protocol/component_images/scale assembly 15.jpg

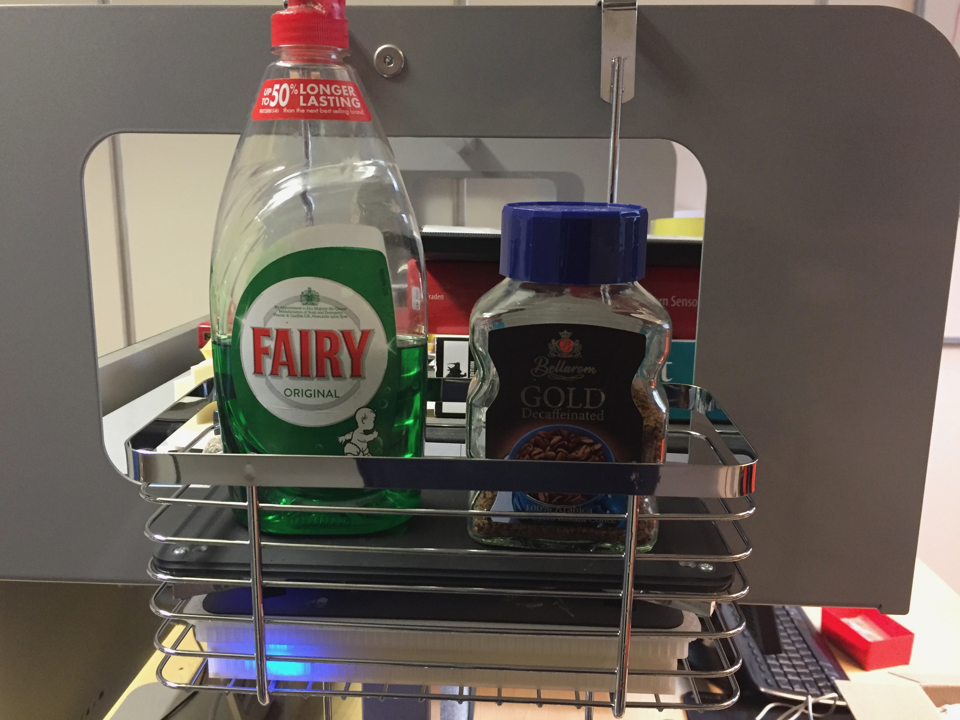
protocol/component_images/scale assembly 15.jpg
