MixedRealityLab/UbiDesign/protocol/component_images/scale assembly 16.jpg

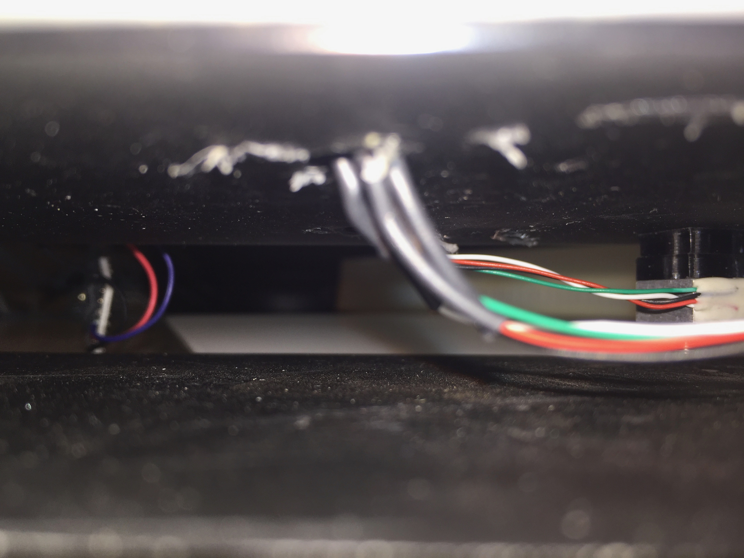
protocol/component_images/scale assembly 16.jpg
