MixedRealityLab/UbiDesign/protocol/component_images/scale assembly 17.jpg

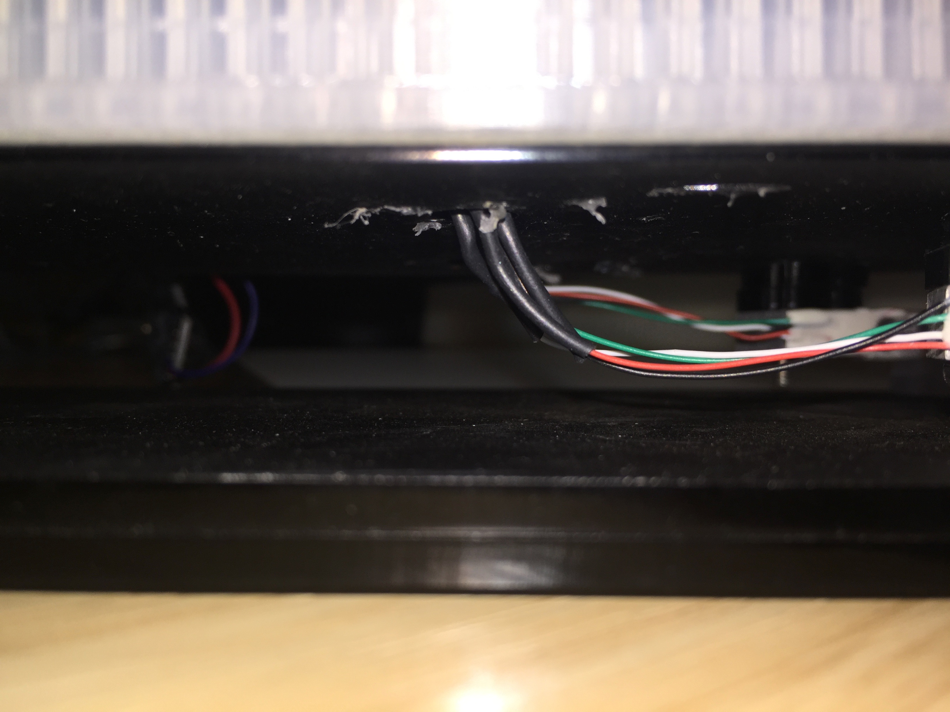
protocol/component_images/scale assembly 17.jpg
