MixedRealityLab/UbiDesign/protocol/component_images/shower head assembly 2.jpg

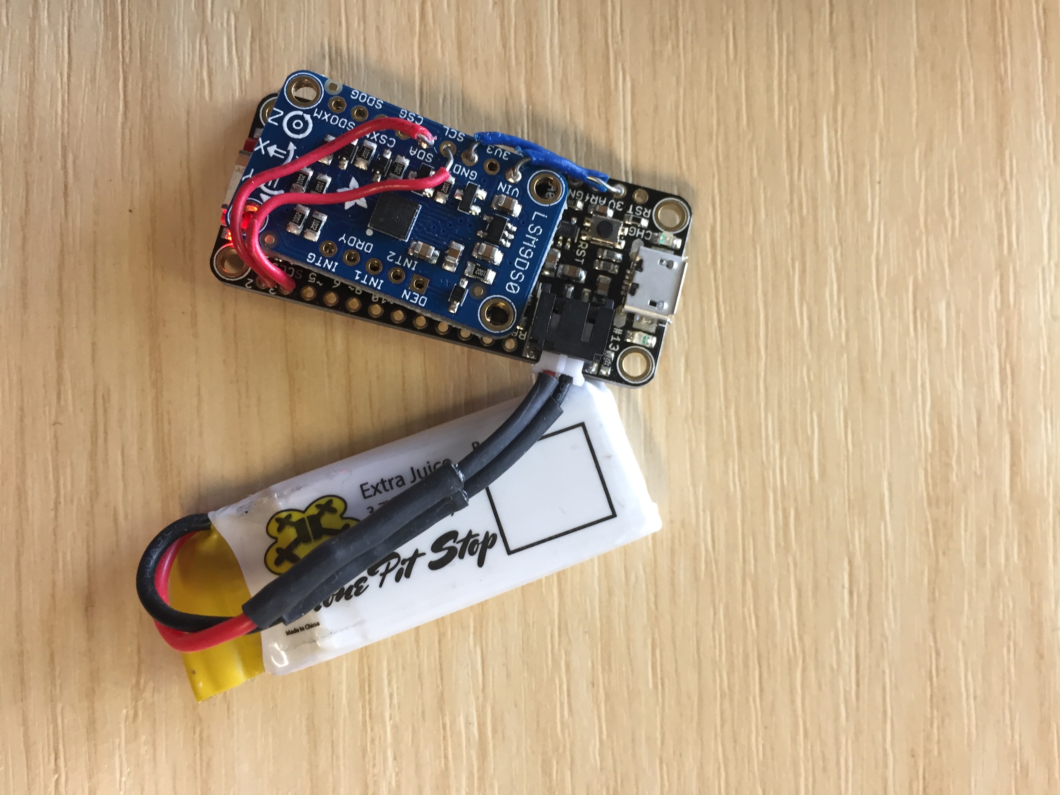
protocol/component_images/shower head assembly 2.jpg
