MixedRealityLab/UbiDesign/protocol/component_images/shower head assembly.jpg

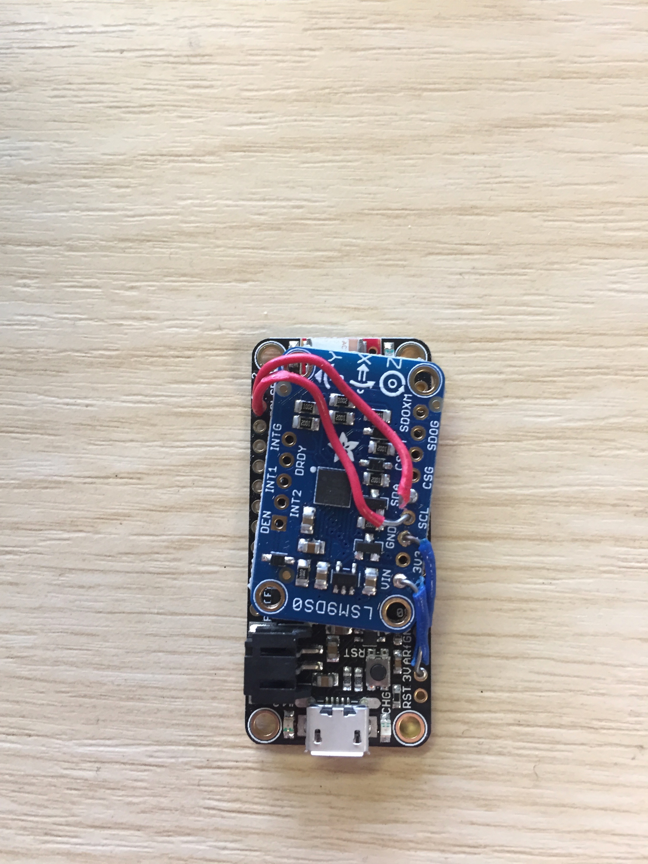
protocol/component_images/shower head assembly.jpg
