MixedRealityLab/UbiDesign/shower_monitor/diagrams/shematic.pdf

## Power board

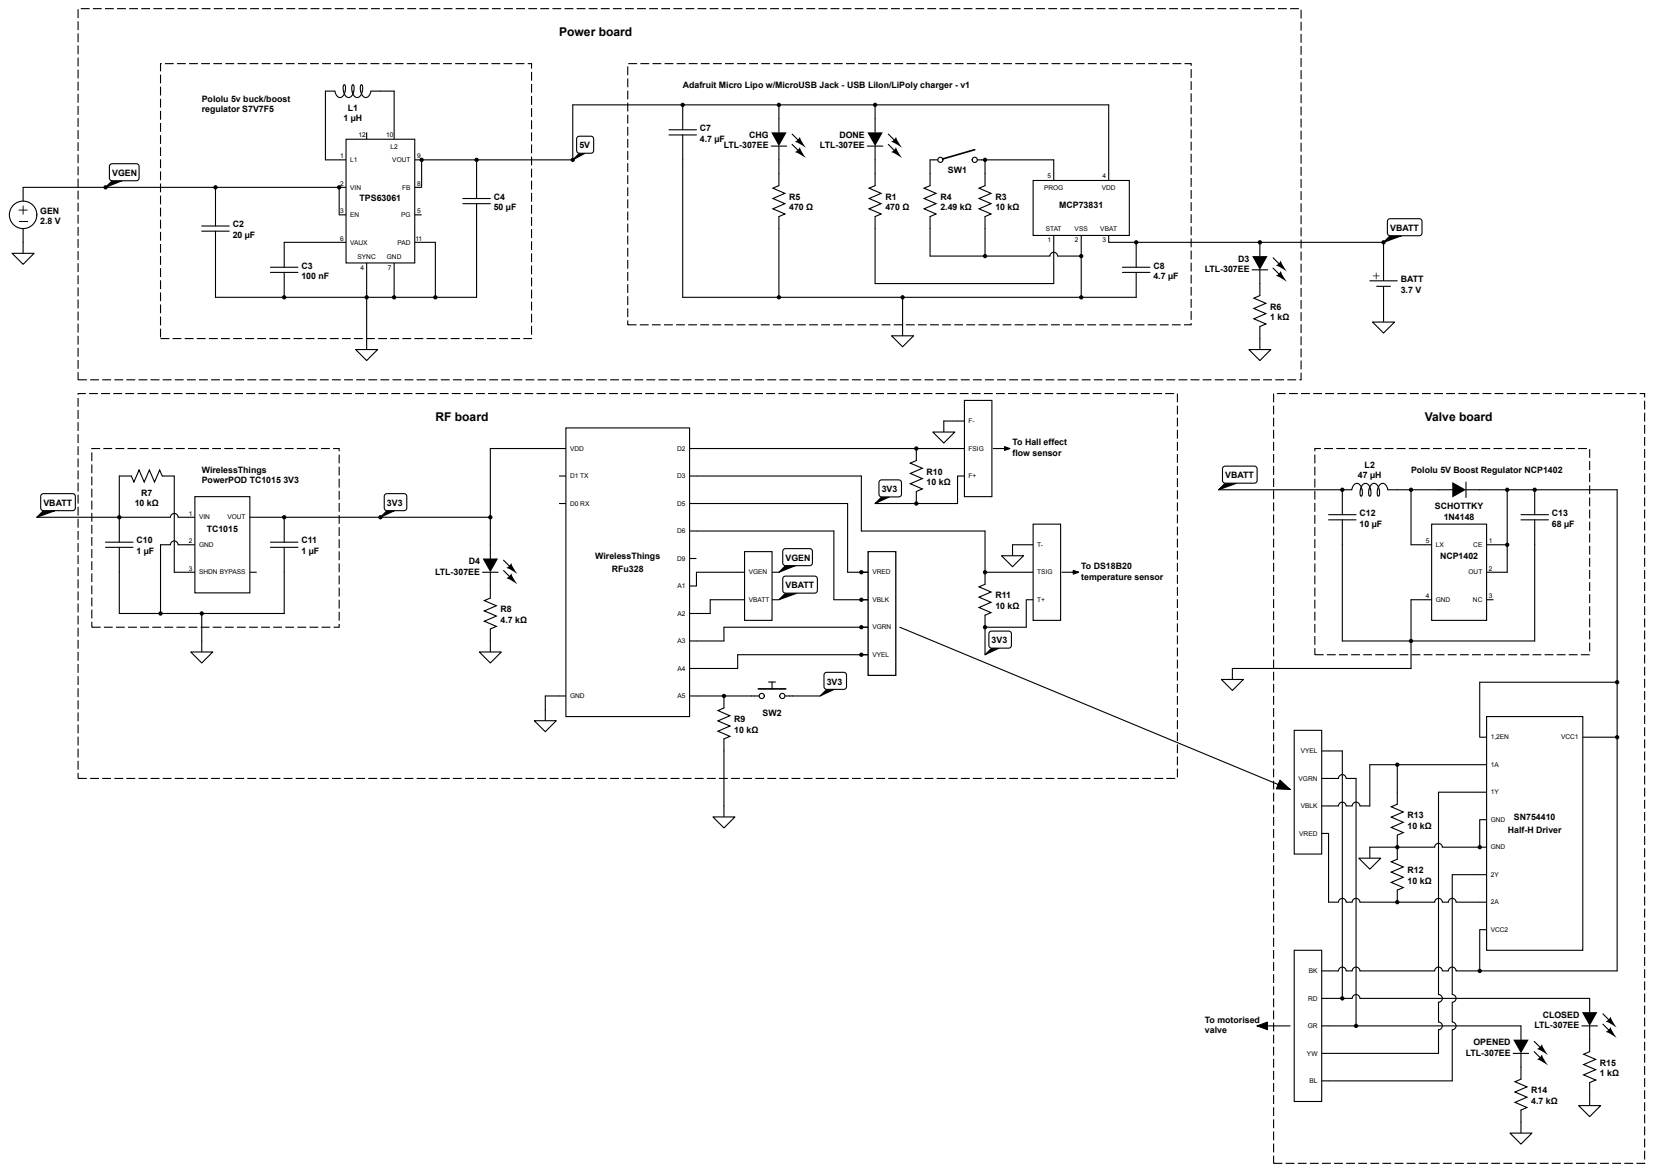
[picture p50: page 1]

Adafruit Micro Lipo w/MicroUSB Jack - USB LiIon/LiPoly charger - v1
