MixedRealityLab/UbiDesign/(commit log)

2017-03-03 fixed ble streaming issue
    [bluetooth_shower_head.py, influx_poster.py, test_scale.py, test_shower_head.py, test_shower_monitor.py, wireless_things.py]
2017-06-05 commited some old bug fixes
    [sim1.csv, sim2.csv, sim3.csv]
